copperdogma/death-fortune-teller/docs/hardware/BOJACK 10 Colors 200 pcs 5mm LED Diode Lights Assored Kit Pack (Transparent DC 2V - 3.2V 20mA) Bright Lighting Bulb Lamps Electronics Components 5 mm Light Emitting Diodes Parts/BOJACK 10 Colors 200 pcs 5mm LED Diode Lights Assored Kit Pack (Transparent DC 2V - 3.2V 20mA) Bright Lighting Bulb Lamps Electronics Components 5 mm Light Emitting Diodes Parts.jpg

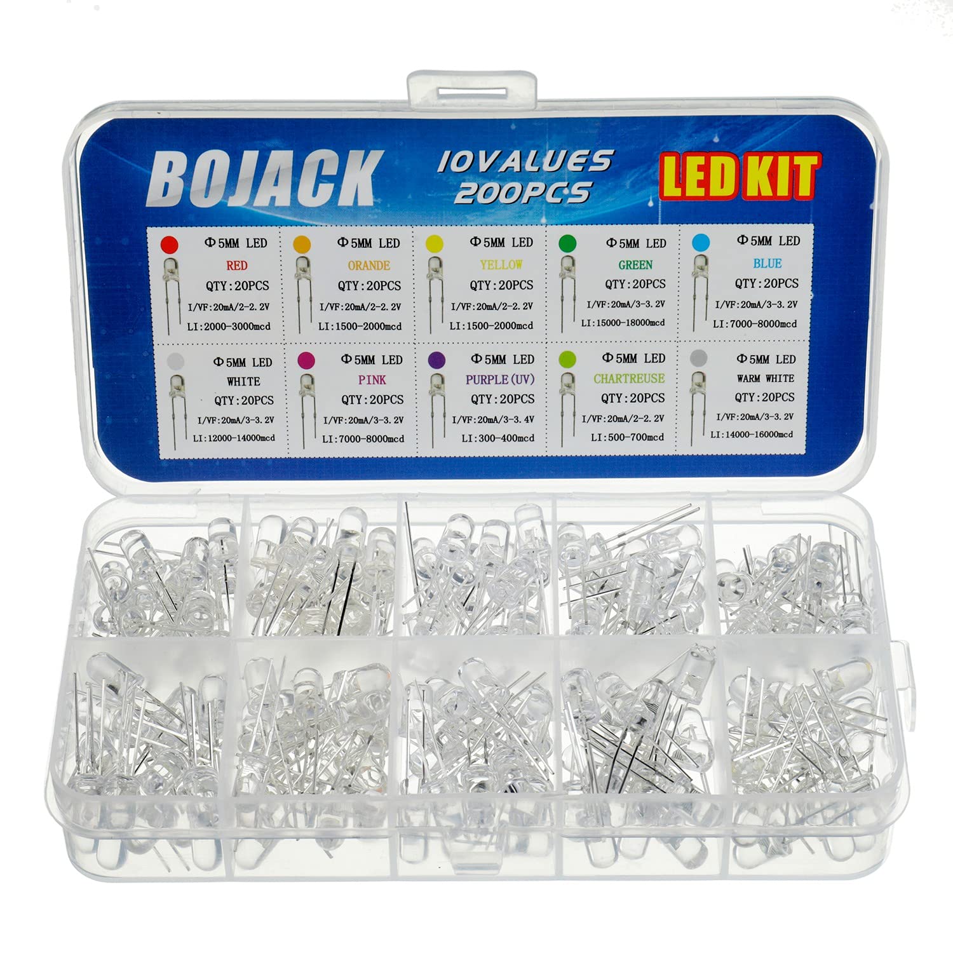
docs/hardware/BOJACK 10 Colors 200 pcs 5mm LED Diode Lights Assored Kit Pack (Transparent DC 2V - 3.2V 20mA) Bright Lighting Bulb Lamps Electronics Components 5 mm Light Emitting Diodes Parts/BOJACK 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
