copperdogma/death-fortune-teller/docs/hardware/Barrel jack, 2.1mm 13mm hole.jpeg

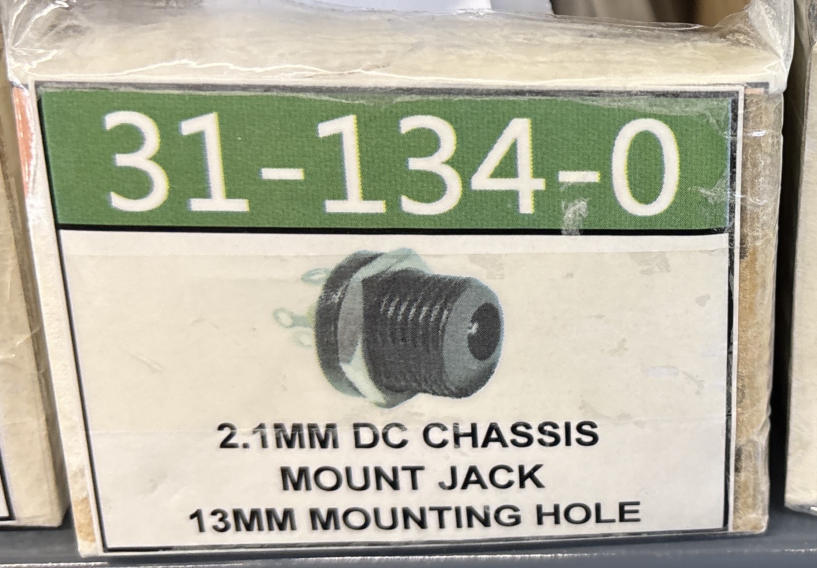
docs/hardware/Barrel jack, 2.1mm 13mm hole.jpeg
