copperdogma/death-fortune-teller/docs/hardware/BOJACK 10 Colors 200 pcs 5mm LED Diode Lights Assored Kit Pack (Transparent DC 2V - 3.2V 20mA) Bright Lighting Bulb Lamps Electronics Components 5 mm Light Emitting Diodes Parts/BOJACK 10 Colors 200 pcs 5mm LED Diode Lights specs.md

# BOJACK 5 mm LED Kit — 10 Colors (200 pcs)

* **Package:** 10 colors × 20 pcs each = **200 pcs**
* **Form factor:** 5 mm, clear lens (through-hole)
* **Nominal drive:** **20 mA**
* **Specs per color** (Vf = forward voltage @ 20 mA, LI = brightness in mcd):

| Color | Qty | Vf (V)  | LI (mcd) |
| --- | --: | --- | --- |
| Red |  20 | 2.0–2.2 | 2,000–3,000 |
| Orange |  20 | 2.0–2.2 | 1,500–2,000 |
| Yellow |  20 | 2.0–2.2 | 1,500–2,000 |
| Green |  20 | 3.0–3.2 | 15,000–18,000 |
| Blue |  20 | 3.0–3.2 | 7,000–8,000 |
| White |  20 | 3.0–3.2 | 12,000–14,000 |
| Pink |  20 | 3.0–3.2 | 7,000–8,000 |
| Purple (UV) |  20 | 3.0–3.4 | 300–400 |
| Chartreuse  |  20 | 2.0–2.2 | 500–700 |
| Warm White  |  20 | 3.0–3.2 | 14,000–16,000 |
