copperdogma/death-fortune-teller/docs/hardware/HS-125MG 24g Metal Gear Analog Slim Thin Wing Servo/HS-125MG Servo.md

# HS-125MG Servo - Hardware Reference

## Product Overview

**Model:** HS-125MG  
**Part Number:** 32125S  
**Type:** Analog Slim Thin Wing Servo  
**Weight:** 24g (0.84 oz)  
**Manufacturer:** Hitec RCD

## Description

The analog HS-125MG is a super thin servo measuring 1.2" x 0.4" x 1.3". Featuring Hitec's MP Gear technology, the HS-125MG is very durable and perfectly designed to fit in the slim wings of today's high performance gliders and aircraft.

## Key Features

- **Super Thin Wing Servo** - Compact form factor for slim wing applications
- **Strong Metal Gears** - Durable metal gear train
- **Dual Ball Bearings** - Smooth operation and reduced wear
- **Perfectly Designed** - Optimized for slim aircraft and glider wings

---

## Performance Specifications

| Parameter | Value |
|---|---|
| **Operating Voltage Range** | 4.8V ~ 6.0V DC |
| **Speed @ 60° (4.8V)** | 0.17 sec |
| **Speed @ 60° (6.0V)** | 0.13 sec |
| **Maximum Torque (4.8V)** | 42 oz-in / 3.0 kg-cm |
| **Maximum Torque (6.0V)** | 49 oz-in / 3.5 kg-cm |
| **Current Draw (Idle)** | 8 mA |
| **Current Draw (No Load)** | 230 mA |
| **Stall Current Draw** | 1,200 mA |
| **Dead Band Width** | 1 µs |

---

## Physical Specifications

| Parameter | Value |
|---|---|
| **Dimensions (Imperial)** | 1.18" × 0.39" × 1.33" (L × W × H) |
| **Dimensions (Metric)** | 30.0mm × 10.0mm × 34.0mm (L × W × H) |
| **Weight** | 24.0g / 0.84 oz |
| **Case Material** | Plastic |
| **Output Shaft Type** | Micro 25 |
| **Dust/Water Resistance** | N/A (Not rated) |

---

## Technical Specifications

| Parameter | Value |
|---|---|
| **Circuit Type** | HT7003 Analog SMT |
| **Motor Type** | 3 Pole Metal Brush Ferrite |
| **Gear Material** | Metal |
| **Bearing Type** | Dual Ball Bearing |
| **Connector Gauge** | 25 AWG / 40 Strand Count |

---

## Recommended Applications

### Suitable For:
- **Sport Planes:** 42-50 oz models
- **Sailplanes:** 3 meter class
- **3D Performance:** 42-50 oz models
- **Slim wing aircraft**
- **High performance gliders**

### Not Recommended For:
- Parkflyers
- Scale aircraft
- Electric helicopters
- Gas helicopters
- Ground vehicles (RC cars, trucks, buggies)
- Marine applications

---

## Power Requirements

### Voltage Performance Chart

| Voltage | Speed (sec/60°) | Torque (oz-in) | Torque (kg-cm) |
|---|---|---|---|
| 4.8V | 0.17 | 42 | 3.0 |
| 6.0V | 0.13 | 49 | 3.5 |

### Current Consumption

- **Idle:** 8 mA
- **Operating (No Load):** 230 mA  
- **Stall:** 1,200 mA (1.2A)

**Note:** Ensure your receiver and power system can handle the 1.2A stall current if multiple servos may stall simultaneously.

---

## Dimensions Diagram

```
Top View:
┌──────────────────────────────┐
│                              │  10.0mm (0.39")
└──────────────────────────────┘
        30.0mm (1.18")

Side View:
        ┌────────┐
        │  Servo │  34.0mm (1.33")
        └────────┘
```

---

## Mounting Information

- **Output Shaft:** Micro 25 spline
- **Mounting Tabs:** Standard servo mounting pattern with 4 mounting holes
- **Thickness:** 10.0mm - designed for thin wing sections

---

## Compatibility Notes

- Standard analog servo signal (PWM)
- Compatible with all standard RC receivers
- Micro 25 output shaft requires compatible servo horns/arms
- Thin profile specifically designed for wing servo applications

---

## Related Products

- **HS-5125MG** - Digital version with improved resolution
- **D145SW** - Steel gear digital alternative
- **D131MW** - Coreless metal gear digital option
- **Metal Gear Set** (Part #: replacement gears available)

---

## Additional Information

**Product URL:** https://hitecrcd.com/hs-125mg-slim-metal-gear-wing-servo/  
**Manufacturer:** Hitec RCD USA  
**Support:** SERVICE@HITECRCD.COM  
**Status:** Check current availability (was listed as "OUT OF STOCK" at time of reference)

---

## Document Information

**Document Type:** Hardware Reference Specification  
**Created For:** AI-readable hardware project documentation  
**Last Updated:** October 2025  
**Source:** Official Hitec RCD product documentation
