copperdogma/death-fortune-teller/docs/ESP32-WROVER-UART.md

# ESP32-WROVER-UART

Excellent questions — UART on the ESP32 is flexible but has some key constraints. Let’s go through this clearly and practically, focusing on your Freenove ESP32-WROVER board.

⸻

🧠 1. The ESP32 Has 3 Hardware UARTs
	•	UART0 — primarily used for programming and debugging (via USB-serial bridge).
	•	UART1 — available for user use, but often partially used by flash operations depending on your setup.
	•	UART2 — fully available for user use.

UART	Typical Use	Default TX/RX Pins	Notes
UART0	Serial console / upload	GPIO1 (TX0), GPIO3 (RX0)	Used by USB interface. You can use it for debugging, but avoid repurposing it if you still need serial upload.
UART1	Secondary UART	GPIO10 (TX1), GPIO9 (RX1)	These defaults are often not usable on dev boards because those pins are connected to flash memory. You can reassign.
UART2	Secondary UART	GPIO17 (TX2), GPIO16 (RX2)	Usually free and safest for general use.

⸻

⚙️ 2. You Can Remap UART Pins Freely

One of the best things about the ESP32 is that most peripheral signals are routed via an internal “IO matrix.”
That means you can map UART TX and RX signals to almost any GPIO — except a few restricted ones (see below).

Example in Arduino:

HardwareSerial MySerial(2);  // Use UART2

void setup() {
  MySerial.begin(9600, SERIAL_8N1, 4, 15); // RX=4, TX=15
  Serial.begin(115200);
}

void loop() {
  if (MySerial.available()) {
    Serial.write(MySerial.read());
  }
}

That gives you a second UART on GPIO4 (RX) and GPIO15 (TX), completely independent of the default serial port.

⸻

⚠️ 3. Pin Restrictions

Not all GPIOs are equal — here’s what to avoid:
	•	GPIO6–11 → used by the onboard flash (don’t touch).
	•	GPIO0, 2, 12, 15 → have special functions during boot; avoid unless you know what you’re doing.
	•	GPIO34–39 → input-only (can’t be TX).

Safe choices for UART RX/TX:
4, 5, 16, 17, 18, 19, 21, 22, 23, 25, 26, 27, 32, 33

⸻

🔢 4. Maximum Number of UART Devices
	•	There are 3 hardware UART controllers (UART0–2).
	•	So, you can have up to 3 separate UART connections simultaneously.
	•	One is typically used for the USB serial (programming/debug).
	•	That leaves two hardware UARTs free for your own devices.

If you need more, you can:
	•	Share one UART among multiple devices (using tri-state lines or bus control — not ideal), or
	•	Use SoftwareSerial (bit-banged) — but ESP32’s software UART is CPU-intensive and unreliable at high speeds. Use it only for slow sensors (under ~9600 baud).

⸻

⚡️ 5. Typical Setup on a WROVER Board

For most projects:
	•	UART0 → USB serial (no changes)
	•	UART2 → external UART device (e.g. GPS, serial sensor)
	•	Optionally UART1 → another serial device if needed, on remapped pins

Example:

Function	UART	TX Pin	RX Pin
Programming / Serial Monitor	0	1	3
GPS (external)	2	17	16
Debug / Sensor (optional)	1	23	19

⸻

🧩 Summary

Feature	Details
Hardware UARTs	3 total (UART0–2)
Freely remappable	Yes, any GPIO except restricted ones
Safe pins	4, 5, 16–19, 21–23, 25–27, 32–33
Max concurrent UARTs	3 (usually 2 free for you)
Software UART	Possible, but limited speed/reliability

⸻

If you tell me which external devices you plan to connect (e.g. a Bluetooth module, GPS, printer, etc.), I can recommend which UARTs and pins to use safely for your specific build.
