copperdogma/death-fortune-teller/ai-work/stories.md

# Project Stories

Death, the Fortune Telling Skeleton

**Note**: This document serves as an index for all story files in `/docs/stories/`, tracking their progress and status.

---

## Story List
| Story ID | Title | Priority | Status | Link |
|---|---|---|---|---|
| 001 | PlatformIO Firmware Bring-Up | High | Done | /docs/stories/story-001-platformio-firmware-bring-up.md |
| 002 | SD Audio Playback & Jaw Synchronization | High | To Do  | /docs/stories/story-002-sd-audio-playback-jaw-sync.md |
| 003 | Matter UART Trigger Handling | High | To Do  | /docs/stories/story-003-matter-uart-trigger-handling.md |
| 004 | Capacitive Finger Detection & Snap Flow | High | To Do  | /docs/stories/story-004-cap-sense-snap-flow.md |
| 005 | Thermal Printer Fortune Output | Medium | To Do  | /docs/stories/story-005-thermal-printer-fortune.md |
| 006 | Bluetooth A2DP Reliability & Testing | Medium | To Do  | /docs/stories/story-006-bluetooth-a2dp-reliability.md |

## Notes
- Story IDs map to future files in `/docs/stories/`; create each file as work begins.
- Update priorities and statuses as planning evolves and milestones complete.
- Consider splitting stories if scope expands beyond a single deliverable.
