copperdogma/death-fortune-teller/docs/stories/story-017-audio-integrity-servo-noise.md

# Story 017 — Audio Integrity and Servo Noise

Status: In Review — audio accepted; breathing retained, servo noise unresolved

## Goal

Resolve the remaining audible static and servo noise while preserving the accepted Matter flow and printer behavior from Story 016.

## Acceptance

- Welcome, fortune preamble and goodbye sound clean to Cam, with raw PCM integrity and underrun telemetry checked against the verified card backup.
- Identify whether servo noise is mechanical or speaker interference; apply and physically verify the appropriate correction without losing jaw animation.
- Start, Dead Stop and Waiting retain their accepted behavior.

## Work log

### 20261025-2211 — Checkpoint pushed; resumed audio and servo work

- **Action:** Committed accepted native rebuild and demo controls as `5ca00cb`, merged the independent remote project-context document, and pushed `main` at `01b7631`. Verified remote hash matches. Unrelated Cursor plan and untracked schematics remain untouched.
- **Evidence:** Story 015 established wrong raw PCM bytes from original card locations on this ESP32, including an isolated older SDK test. The fresh initialized clip returned the expected hash twice and Cam heard clean audio. This supports testing fresh allocation for all clips, without claiming the physical cause is established. Qualified TwoSkulls reader remains restored.
- **Next:** Requested approval for a preserved-original audio-folder rebuild and clarification of servo noise type. Read-only servo implementation/hardware audit delegated; root owns all hardware access. No firmware or card changes yet.
- **Observation:** Attempt to open live serial without reset failed during termios setup with EINVAL; no command was sent. Inspect ownership/device state before retrying.

### 20261025-2215 — Prepared controlled comparisons

- **Audio:** Reverified all 40 staged audio-folder files (22,010,672 bytes) against the preserved card backup: zero mismatches. Nine actual WAVs show only 0–0.0002% of samples near full scale; this does not establish clean source audio by listening, but provides no evidence of widespread hard clipping. AppleDouble metadata is excluded from WAV decoding. Card changes remain pending approval.
- **Servo audit:** Card calibration already uses historical quiet 1750..2100 µs reversed limits. Current 50 Hz hardware PWM uses a separate timer from eyes, avoids redundant writes, and has power management disabled. Historical issue notes describe movement buzz even when fixed positions were quiet; do not treat an old redundant-write hypothesis as a demonstrated fix.
- **Next:** Prepare idle-only normal/hold/off pulse diagnostic commands, defaulting to existing normal behavior, before any firmware test. Compare by listening after Cam identifies the noise type. Source/research details will accompany implementation; no calibration changes or hardware wiring changes planned.

### 20261025-2225 — Approved card rebuild; mechanical noise isolated by scope

- **Human input:** Cam identifies mechanical jaw buzzing/chatter and approves rebuilding all audio files while preserving the original folder. Requested card transfer to the computer; card not mounted yet. No card changes performed.
- **Resource recovery:** Disk now has about 4 GiB free; no agent cleanup was performed. General host sanitizer suites and Death flow/assets/fortune suites now pass, including new jaw-mode transition tests. Native diagnostic build is running.
- **Servo:** Added idle-only `jaw-mode normal|hold|off`, default normal after reboot. Hold suppresses motion at calibrated closed target; off stops pulses while preserving eyes; resume forces pulse restoration and a fresh idle cadence. No calibration change. Research and remaining uncertainty recorded in `docs/research/2026-10-25-servo-noise-isolation.md`.
- **Card operation preparation:** `scripts/rebuild_audio_folder.py` checks the exact 40-file staging against backup and current card, copies to a new directory, fsyncs, verifies twice through uncached reads, then archives the original folder and switches the new one into place. Existing extras (including the earlier diagnostic copy) remain in the archive. Local temporary-directory rehearsal passed dry-run/no-mutation, full verification, preserved extra file, and repeat/overwrite refusal. Ready for the approved physical-card operation; no formatting or existing-file deletion.
- **Build result:** Native ESP-IDF diagnostic build passed. Not flashed while awaiting the requested card transfer; accepted printer/flow firmware remains installed. New experimental work remains uncommitted.

### 20261025-2235 — Reader reproduces corruption; card writes stall before switch

- **Preflight:** Card mounted as H-DEATH, disk4s1, FAT16, UUID E25CA0ED-2D75-379D-BA54-C01AF20645BD. Strict guard stopped before writes because seven WAVs differed from backup. Two preserved uncached snapshots of each of nine WAVs showed seven mismatching/changing files. Original initialized returned three changing hashes; fresh diagnostic copy remained exact across three reads. Earlier computer-reader consistency no longer holds.
- **Preservation:** Saved snapshots/report under ignored `card-reader-unstable-before-rebuild`. Reviewed explicit unstable-original restore path: no original data writes, unchanged path/size/mtime checks, source remains exact verified backup. Local differing-original rehearsal passed.
- **Copy attempt:** Initial metadata copy stopped on exclusive-creation collision with macOS-generated AppleDouble; retained metadata-only staging under `audio-rebuild-attempt1-20261025`. Reworked new active content to nine WAVs only, leaving all metadata in original archive; local test passed. Primary Apple source and decision recorded in SD research note.
- **Stall:** Second attempt hung on `mkdir` (confirmed by process sample), and a separate directory listing also entered kernel I/O wait. No verification/switch completed; original `audio` folder not renamed or rewritten. Sent SIGINT to the owned copy process to prevent continuation after the blocked call returns. Requested normal disk4s1 unmount, pending. No forced unmount, format, cleanup or flash performed. Candidate servo image SHA256 f8b65a03448954f504a575978e48ca2ba8412a43309ad80e4d1e3e176060e4c5 remains unflashed.
- **Next:** Resolve removable-media I/O stall before further card writes. Replacement card is the practical next cross-test given corruption now reproduced outside ESP32; card versus reader hardware is not conclusively separated. Servo listening still requires powered board and human feedback.

### 20261025-2239 — Retry completed; nine fresh assets verified

- **Human steering:** Cam suspected Finder had crashed and requested another attempt. Confirmed old copy/unmount processes had exited and volume access responded. Retained the failed staging entry under `audio-rebuild-attempt2-20261025`; original audio still intact. Added per-file progress reporting before retry.
- **Result:** Retry copied all nine actual WAV assets (21,865,236 bytes), passed two uncached whole-folder verification passes and final post-switch verification. Original 42-file folder retained as `/audio-original-20261025` with paths/sizes/mtime preserved and no data writes; original readback hashes still differ across reads, explicitly reported `original_readback_stable=false`. Do not mistake successful retry for restored original read integrity or proof of Finder causality.
- **Evidence:** Ignored `audio-folder-rebuild-retry-result.json` reports verified=true/original_preserved=true/original_bytes_not_written=true. Active `/audio` contains exact qualified backup WAVs. Mac metadata remains in original archive; failed staging entries retained, no cleanup or format.
- **Next:** Normal unmount, return card to Death, verify streamed PCM and listening for Welcome/preamble/goodbye. Then flash built servo diagnostics and compare normal/hold/off mechanical sound. No firmware flash or new commit performed yet.

### 20261025-2242 — Fresh Welcome matches on ESP32

- **Return:** Cam returned card, powered board and reconnected USB. Non-reset serial attached successfully. SD mounted, nine active assets found, saved speaker connected, no stream fault.
- **Welcome:** Local `/audio/welcome/welcome2.wav` completed 540540 frames, raw FNV1a `f5800043` exactly matching verified backup, 1079500 nonzero samples/peak32761, zero underruns. This is device-side evidence of correct fresh-location data through a full 12.26-second clip. Human listening question pending.
- **Next:** Playing `/audio/fortune_preamble/fortune_2_typewriter.wav` as a longer data-integrity comparison. No printing triggered. Servo diagnostic image remains built/unflashed until current playback is finished.

### 20261025-2244 — Longer stream exact; servo image flashed, warm SD init blocked

- **Audio:** Cam answered Welcome sounded “Clean.” Fortune preamble 2 completed 746337 frames, raw FNV1a `db38260b` exactly matching backup, 1491196 nonzero samples/peak20593, zero underruns. Human preamble listening acceptance and goodbye remain pending. Validation report captures the separate machine/human results.
- **Flash:** Closed serial after explicit Stop/Waiting. App-only upload at 0x30000 verified hash for diagnostic candidate f8b65a03448954f504a575978e48ca2ba8412a43309ad80e4d1e3e176060e4c5; NVS/Home preserved. Controlled reset launched application.
- **Current boot:** SD card initialization times out in OCR/send_op_cond before actuator/config/radio startup. Repeated mount retries report ESP_ERR_TIMEOUT; no jaw comparison possible yet. Servo diagnostics run after mount, so no evidence that jaw-mode logic causes this initialization failure. Requested one full power removal including USB to reset card and board. No blind firmware rollback, card format, or new wiring changes.

### 20261025-2255 — Separated motion chatter and damaged recording samples

- **Power-cycle result:** SD initialized, speaker reconnected, startup announcement completed. Hold mode was accepted. Cam: held jaw “Quiet now”; normal breathing “noisy during movement, quiet between breaths.” Returning to hold quieted jaw for audio tests. Continuous idle holding torque was not noisy in this comparison; pulse-off comparison unnecessary at this point.
- **Goodbye:** Full 887196 frames delivered, backup FNV `6a740064`, zero underruns, repeated exact on replays. Cam corrected initial clean assessment to about six clicks, repeating exactly near halfway and in the final five seconds. Treat as remaining audible defect, not acceptance.
- **Source diagnosis:** Compared all nine project WAVs against the card backup: six backup WAVs contain sparse predominantly single-bit PCM changes. Goodbye has 616 differing bytes/635 bits and isolated full-scale impulses; project original has no matching impulses and peak19552. At10.940476s backup samples -21/-32766/23 correspond to project -21/2/23. Source spikes match reported click timing. Exact prior stream hash proves faithful damaged-backup playback, not pristine audio. Full evidence in `docs/research/2026-10-25-audio-source-bit-damage.md`.
- **Pristine preparation:** Independently read project originals uncached twice, snapshotted all nine (21,865,236 bytes), verified snapshot and saved manifest. Pristine Goodbye FNV `487245a5`. Rehearsed restore preserving both earlier folders; PASS. Cam transferred card for this restore. No runtime audio filter or buffer change.
- **Current card operation:** Clean restore started with unique `audio-pristine-staging-20261025` and intended archive `audio-backup-copy-20261025`; stopped progressing after first file while creating next directory. Process sample again shows `mkdir` wait. Sent SIGTERM to owned process and requested normal unmount, both pending kernel I/O completion. Original archive and active backup-derived folder have not been switched/replaced. Asked about another reader or replacement card; no forced ejection, repair, format or repeated write loop.
- **Servo candidate:** Eased fractional idle/boot motion interpolates between existing integer-angle calibrated PWM values. Travel/timing/endpoints/speech/overrides preserved. Dense20ms monotonic/fractional/endpoint tests plus full general host sanitizer suite PASS; native build PASS. Candidate SHA256 `81d607261dc25165a0397734f6db8a5204b2cf1d4abe758035c7a67ef428babd`, not flashed. Current installed diagnostic image remains f8b65a03…, default normal on power-cycle. Mechanical improvement still needs listening.

### 20261025-2301 — Replacement card formatted and verified with original recordings

- **Prior operation release:** Stalled restore process exited after SIGTERM; normal unmount first reported Backblaze `bzserv` dissenter, then succeeded after its handles cleared. Backblaze was inspected read-only; no backup settings changed or service killed. Ejection blocker does not establish Backblaze as the cause of sample damage or directory stalls.
- **User action/scope:** Cam inserted a different card and authorized preparation, then explicitly requested formatting and the same name as old card. Replacement initially labelled WYZE_STOCK, FAT32, UUID F09E442D-04EF-392F-A76E-5117196E878D; old H-DEATH card UUID E25CA0ED-2D75-379D-BA54-C01AF20645BD remains untouched by this formatting. Preliminary non-destructive copy verified three times, then user-requested format erased replacement card contents.
- **Format:** Rechecked replacement UUID/name/whole disk immediately before `diskutil eraseDisk FAT32 H-DEATH MBRFormat /dev/disk4`. Succeeded. New volume UUID87906DF2-96A7-3A60-B001-5647BD0A287E.
- **Load/verify:** Copied nine pristine project WAVs, saved1125-byte config, exact727-byte fortune JSON and pirate BMP from verified local sources. All12files passed three uncached read-back SHA256 checks after fsync. No stalls or mismatches. Report/manifest retained as ignored `replacement-card-formatted-preparation.json`. Old card and its retained folders/backups remain available; camera image on replacement was erased only under explicit format authorization.
- **Next:** Safe eject, return replacement to board with USB, app-only flash smooth servo candidate, then verify pristine Goodbye against FNV487245a5 and listen for both clicks and jaw-motion change. No new commit/push after the accepted checkpoint.

### 20261025-2324 — Clean audio accepted; control timing remains under investigation

- **Installed:** App-only smooth candidate81d60726… flashed and hash-verified. Replacement SD initialized on first post-flash boot, startup staging/PSRAM hash bothd6d8b5d5, saved speaker reconnected. No full power-cycle recovery needed this time.
- **Audio acceptance:** Pristine Goodbye completed887196frames, FNV487245a5, peak19552, zero underruns. Cam: “Clicks are gone.” This verifies original source data rather than merely faithful playback of damaged backup bytes.
- **Servo trial:** Cam judged eased breathing “About the same” for noise. He explicitly wants to retain breathing. He notes the expensive servo is louder than Jeff/Anthony and O-rings already insulate mounts; don't repeat generic mounting advice or infer a mechanical cause from one unsuccessful smoothing experiment. Quiet holding and noisy movement do not rule out control timing.
- **Next experiment:** Passive MCPWM hardware edge capture on GPIO23, two channels rising/falling, without altering LEDC output. Bounded8second acquisition, internalISRring/PSRAMhistory, hardware timestamp analysis, recorded commanded duty, output configuration verification and cleanup. Both channel latches share APB with LEDC; capture gaps and common-mode clock drift are explicit interpretation limits. Captures will compare hold and normal breathing. New pure analysis and actuator telemetry tests plus allgeneralhost/Death suites PASS; native build running. Diagnostic does not change motion endpoints/timing/calibration. No hardware timing result yet.

### 20261025-2334 — Passive output measurement complete; breathing restored

- **Build/flash:** Native observer build and allhostsanitizer/Deathflow/assets/fortune suites PASS. App-only SHA5b2d61fb7a498f5c80552c5415aff7e997e6ecd725c33fc777e2f2407db83f11 uploaded/hash-verified. Replacement SD mounted immediately; startup staged/PSRAM FNVd6d8b5d5; speaker connected on second remembered attempt. No pairing/NVS reset.
- **Held capture:** 400 complete periods exactly20ms; pulse width2094.125µs constant; no ring drops/gaps/invalidwidths. Output GPIO configuration preserved after cleanup.
- **Breathing capture:** 399 complete periods exactly20ms; width2041.0125..2094.125µs; maximum adjacent change3.0625µs consistent with maximum programmed change3.05176µs atcapturequantization. No ring drops/gaps/invalidwidths, one initial/unpaired edge. Output configuration preserved after cleanup. Structured results in `docs/validation/2026-10-25-servo-pwm-capture.json`.
- **Interpretation:** No unexpected waveform jitter/malformed pulse observed in these windows. This does not rule out commanded movement/update cadence, analogue waveform/supply atservo, or mechanical load. Do not dismiss Cam's control-code hypothesis as disproven; expensiveunit/O-rings do not locate cause. Historical high-speed versusnative low-speed difference researched but not changed without a waveform-fault result.
- **Handoff:** Normal breathing enabled, Waiting, SD/speaker connected, printer idle, no stream fault/reset. Audio clicks accepted gone on original project recording/newcard. Mechanical movement noise remains; Cam explicitly requested retaining breathing and initially accepted its movement noise, with control-code investigation left as an open finding. Easing had no demonstrated acoustic benefit; no claim it fixed noise. Story remains InReview rather than marking noise eliminated. Current internalfree~25.7KiB, observed transientmin2.1KiB later inrun; no allocation failure/reset observed. Further resource/fullflowsoak remains future qualification. Observer releases runtime capture allocations/interrupts; CLI dormant when unused. New work uncommitted, old unrelated Cursorplan/schematics untouched.

### 20261026-1108 — Investigating intermittent Home Start interruption

- **Report:** Two Home Start attempts began speech and stopped early; a subsequent attempt appeared to work. Servo research paused. No cause established from that report.
- **Evidence preservation:** No reboot/flash. Initial serial attachment failed with macOS termios EINVAL, also reproduced by stty. User reconnected USB while instructed to retain main power; non-resetting relay then connected successfully. Current uptime ~773 seconds, Start acceptance counter4, Waiting, SD/speaker/stream available, radio fault0/dropped0. Latest playback delivered490880frames with zero underruns, producer had prepared497448frames; these partial counters cannot identify the earlier abort cause. Printer completed0/cancelled1. No durable SD log or general RAM log history exists in installed firmware. Earlier messages emitted while disconnected cannot be reconstructed from these counters.
- **Capture:** Private ignored log `firmware/build/validation/death-first-flash-20261025/story017-intermittent-start-20261026.log`. Asked Cam to run one Home Start with logging attached, noting completion/early stop and Waiting behavior. No new Start captured yet at this checkpoint.
- **Diagnostic gap:** Existing show abort paths all log only State=cancelling. Added reason/phase/asset/uptime and a small fixed-size last-interruption snapshot, retained across later shows until init/reboot, exposed in regular status. Distinguishes explicit Dead Stop, speaker stream loss, audio prepare/read/start failure, prebuffer timeout and printer timeout. Added selected-asset/expected-frame logging and boot esp_reset_reason output. No SD writes, playback/provider/buffer changes, retries or recovery-policy changes.
- **Research/application:** General problem class is intermittent asynchronous failure with missing fault provenance. Existing installed ESP-IDF esp_system.h documents reset-reason distinctions (panic/watchdog/brownout/software); use that API rather than infer a reboot from silence. Volatile last-fault retention plus live serial capture is the bounded next experiment; it cannot recover past events or survive power loss. The pySerial API documents port-setting failures/possible line activation on open; no reset pulses were intentionally sent.
- **Validation:** Production-source Death flow/assets/fortune ASan/UBSan suites PASS, including retained failure across later playback, precise link-loss/timeout/read-failure reasons, and Stop/error race precedence. Native firmware build PASS; git diff --check PASS. Diagnostic candidate compiled only; not flashed while preserving current run. No commit/push.

### 20261026-1112 — Reproduced cutoff: explicit SD CRC failure

- Cam reports Welcome stopped at “…Death, the diviner, oracle of—”. Live capture shows Home Start accepted uptime978890ms, Welcome978910ms, SDMMC error986180ms: sdmmc_read_sectors_dma sdmmc_send_cmd returned0x109, status0x900; diskio_sdmmc read failed. Cancelling986220ms, cooldown986240ms, Waiting998250ms. No intervening Dead Stop command, Bluetooth state loss, reboot or underrun. Failure is an SD read/CRC failure, not evidence of Home rejecting Start or queue starvation. This is the replacement card, not the previously replaced card.
- Last successful producer block363/320166frames; delivered314752frames (~7.14s). Radio remained connected/stream-ready/fault0. Mounted flag1 describes filesystem state, not ongoing read integrity; previous status headline cannot establish card health.
- Next normal-jaw local Welcome replay failed at initial read within20ms, same0x109/status0x900. No fortune queued. Existing files unchanged. Next bounded comparison disables jaw PWM only temporarily, retaining all saved settings and restoring normal breathing after capture. CRC failure could reflect card/socket/power/signal/controller path; current evidence does not identify which.
- Primary references checked: ESP-IDF5.5.4 esp_err.h defines0x109 ESP_ERR_INVALID_CRC; sdmmc_cmd.c read path propagates failed transfer and checks CMD13. Espressif v5.5.4 SD example documents signal integrity/pullup/clock requirements: https://github.com/espressif/esp-idf/blob/v5.5.4/examples/storage/sd_card/sdmmc/README.md . Earlier low-clock failures concerned the old card and silent wrong bytes; do not assume their result proves this replacement-card CRC failure has the same cause.

- **Jaw isolation results:** Normal local replay1056040ms failed CRC at1056060ms during initial read. PWM-off replay1091700ms completed540540frames/rawFNV9f4f6cb1/peak19558/zero underruns. Restored-normal replay1133890ms failed CRC1137690ms after162304deliveredframes. Second PWM-off replay1172640ms failed CRC1172660ms before first PCM block. Thus motion/pulses are not required to reproduce the error; no servo-causal conclusion from one passing off trial. GPIO pulse-off does not physically isolate servo power.
- **Restored:** Jaw mode normal accepted1216280ms; Waiting, SD still mounted, speaker connected, zero radio fault/drops. Saved settings/files unchanged. No reset/flash performed. Diagnostic-only source candidate remains built/tested but uninstalled. Cutoff mechanism established; underlying CRC cause and durable fix remain open. Next useful controlled test is replacement-card SD clock reduction with hash-verified full clips, or measured card supply/socket/signal integrity. Do not add unchecked fread retries that could publish partial/corrupt blocks.
