copperdogma/death-fortune-teller/docs/stories/story-019-reliable-sd-playback.md

# Story 019 — Reliable SD playback on replacement card

Status: In Progress. User says intermittent stops are a killer and must be fixed.

## Acceptance

Establish a reliable operating configuration with hash-verified full clips,
repeated full-flow/Home Start use and idle/reboot recovery. Human playback/print
acceptance remains distinct from host/native build checks. Retain breathing,
Matter pairing and fault reports. No card formatting or asset modifications.

## Work log

### 20261026 — Baseline and bounded next experiment

- Logger-only checkpoint83497e7 pushed and remote verified. Exact staged tree host/Death flow/assets/fortune suites PASS; earlier servo experiments remain uncommitted. Unrelated Cursor plan/schematics preserved.
- Replacement-card baseline20MHz already has several CRC0x109 aborts, including full Home Start failures with speaker stream up/zero underruns and one failure with jaw pulses off. Successful Welcome has540540frames/FNV9f4f6cb1. New logger retained actual first failure while archive initially EIO, then recovered on a later SD write.
- General problem class: intermittent storage transport integrity, not PCM queue starvation. Bounded primary research confirms ESP-IDF5.5.4 supports reduced SDMMC clock, real-frequency query and external pullup requirements. Native source mounts1-bit at20000kHz; actual board pullup resistance/supply waveform not yet physically verified. Old-card low-clock/wrong-byte tests do not qualify replacement-card behavior.
- Added idle-only volatile `sd-clock 4000|10000|20000` with SDK real-frequency query. No CRC disable, audio buffer/reader/retry change, card remount or asset write. Boot baseline remains20MHz for now. Compare20 and10MHz on the same card/boot with normal jaw, exact clip hashes and full frame counts. Next steps follow the observed comparison rather than arbitrary retries.
- Sources: https://docs.espressif.com/projects/esp-idf/en/v5.5.4/esp32/api-reference/peripherals/sdmmc_host.html ; https://docs.espressif.com/projects/esp-idf/en/stable/esp32/api-reference/peripherals/sd_pullup_requirements.html ; https://github.com/Freenove/Freenove_ESP32_WROVER_Board . Manufacturer board reference does not prove this particular assembled board's electrical condition.

- Existing installed firmware already contained an older idle `sd-clock` branch, discovered during review; used it for live comparison without flash. Candidate consolidates the duplicate branch into the stricter guarded API with SDK real-frequency query. Fixed host aggregate fixture/linkage while qualifying the new API; targeted storage sanitizer test PASS. Initial new native build permission review timed out before execution (not a safety finding); no hardware change resulted and a single retry is available when needed.
- Same boot/card, normal jaw:20MHz Welcome aborted CRC0x109 after142592deliveredframes (~3.23s). Switched10MHz ESP_OK; next Welcome failed CRC during initial read. Switched4MHz ESP_OK; Welcome completed540540frames/FNV9f4f6cb1/zero underruns. Archive failures at20MHz also observed. One4MHz pass is a lead, not accepted fix; repeat and return to20MHz next.

- Repeated4MHz Welcome: full540540frames/FNV9f4f6cb1/zero underruns again. Returning20MHz on same boot immediately reproducedCRC at~2.0s/88704deliveredframes. Same normal jaw/speaker/reader/buffers throughout. This A/B/A materially links observed reliability to SD clock margin, while physical cause remains unmeasured. Restored4MHz and moved to longer fortune4 clip next. Manufacturer pinout labelsGPIO2/DAT0 shared with onboard LED; no populated schematic/external pullup evidence in repo. Treat loading/pullup/supply as hypotheses, not proven defective part.

- Longer fortune4 failed on its initial read even at4MHz. Therefore slower clock is not a verified fix; do not change boot default/adopt based on the two short passes. A4MHz direct initialized reference check still passed twice425700bytes/FNVd6d8b5d5 with zero bad chunks. Broadened framing from simple speed threshold to intermittent transfer integrity, potentially pattern/file/access-path dependent.
- Built diagnostic appaa10e63aa9d2d7e1c79f5f370ab2b59be7a9ac7d6127e33fd9df2c8db20ef184; app-only flashed/hashverified. Local SDMMC driver debug records enable only sdmmc_req at runtime, so response CRC versus data CRC raw interrupt status can be distinguished without SDK source edits. Added reversible idle `sd-continuous 0|1` via documented sdmmc_host_set_cclk_always_on; frequency change/reboot resets it. Continuous clock is an isolation experiment supported by the SDK, not a claimed migration regression (both old/new SDK gate clock by default).
- Asked Cam whether a multimeter is available; no measurement result yet. No wiring changes, card writes beyond existing fault logger or CRC suppression. Targeted storage sanitizer test and native diagnostic build PASS.

- Error-status image booted cleanly; initialized probe twice20MHz425700bytes/FNVd6d8b5d5 while speaker unavailable. No runtime CRC captured yet in that image. Bootstrap command-response timeout debug records are expected during card probing and are not classified as a new playback fault.
- Speaker reconnect attempts now fail/exhaust rather than delivering startup. Asked Cam whether JBL remains powered on; can continue read-only SD testing independently. Added `sd-file <catalogued audio path>` guarded against active show/audio/file/startup-playing/printer/tone. Generalized existing aligned4096 internal-DMA probe to8MiB cap without changing startup loading/provider or initialized reference checks. New API arbitrary-path/large-file bounds and every startup mode pass targeted ASan/UBSan; native build passes. This direct audit is a different read path from streamed PSRAM stdio, so interpret passing hashes narrowly. No source changes to waveform assets.

- General file-audit image6a6eb87ce2db8d9bc3f55f82b0c0c6750f09abf1135f13afa9345a5fe0fa394e installed/hashverified; full host suite PASS. Speaker currently disconnected/awaiting owner reply. At20MHz, aligned internal-DMA direct probes passed fortune4(3797364bytes,b828da54), Welcome(2162160,9f4f6cb1), Goodbye(3548784,487245a5). These are full pristine hashes of files that fail in playback, not acceptance of the streamed path. Auditing all9next and preparing an exact PSRAM stdio/cadence probe to discriminate I/O path from BT/speech-load effects before assigning electrical cause.

- Full aligned-DMA audit of all9clips at20MHz passed exact pristine FNVs;12total full-file reads including earlierthree, allcorrect. Corresponding read-only PCM totals match source data.
- Added controlled PSRAM-stdio audit:8192B PSRAM setvbuf,3528B PSRAM PCM buffer/882frame reads, one tick yield aftereach2blocks, same waveform parser/hash with no retries/gain/provider. This reproduces stream I/O shape but omits gain/muting/RMS/queue/network delivery. Both allocation-failure cases, 8MiB bounds and existing startup modes pass sanitizer tests. Native build required explicit FreeRTOS.h before task.h; fixed both production include order and host stub guard to catch regressions. Full host suite/native build PASS.
- Installed diagnostic imagede1a3b323cccd1f754676862422cc253a24817ae6a58d6c3204b9826c1b475b0 app-only/hashverified. At20MHz with no speaker stream, stdio audit passed fortune4(3797364,b828da54), Welcome(2162160,9f4f6cb1), Goodbye(3548784,487245a5). No runtime CRC status captured in these quiet-stream audits. WiFi/Matter and BT controller remain enabled; do not call this a radios-off test or conclude a specific radio/power cause.
- Speaker still unavailable after bounded retries/inquiry. Owner questions pending for JBL power and meter availability; need active speaker playback to reproduce/classify error under originalconditions and qualify any fix. No lowerclock default, automatic read retries or waveformchanges adopted. Remaining hypotheses include RF/power/load interaction, command/data protocol path and per-file/traffic timing; none proven. Continuous-clock diagnostic present but not yet tested under failing playback conditions. Normal breathing enabled, Waiting/startup awaiting speaker, bootdefault20MHz. Logging checkpoint83497e7 is pushed; new SD diagnostics remain uncommitted.

### Powered speaker and settling-controlled playback

- Cam confirmed speaker had powered off and turned it back on; meter available but not yet out. Mac serial reattach initially EINVAL; user USB reconnect fixed it without board reset. Later improved private serial relay to open at9600 then set115200 (standard pySerial supported sequence) and capture3600seconds; reopened successfully without another USB reconnect. This is host diagnostic plumbing, not an SD firmware fix.
- Cached JBL reconnected on first explicit retry, stream enabled/startup announcement delivered. With active silent BT stream, both PSRAM-stdio and aligned-DMA audits of fortune4 passed3797364bytes/FNVb828da54. Thus radio streaming alone did not reproduce the fault in these trials.
- Corrected isolation rigor: jaw off was allowed to settle ~12s before local fortune4 playback. Completed949341frames/FNVb828da54/zero underruns. Restored normal, settled, same full clip also passed exact hash/frames. Welcome at SDK-measured20000kHz then passed540540frames/FNV9f4f6cb1/zero underruns. Earlier rapid mode-switch/header-failure tests did not prove physical off had settled before I/O; do not overstate them as elimination of servo load.
- Human Home Start: Cam says whole thing played perfectly. Board logged full Welcome/preamble/one completed print/Goodbye487245a5/cooldown/Waiting, no read errors or interruptions. This is one accepted full flow, not a causal fix: only diagnostic features have changed and boot speed is still20MHz.
- Bounded Matter audit: OnOff attributes are NONVOLATILE; current app does not enable deferred persistence, so no configured3second deferred timer is active. SDK set_val may write NVS synchronously when values change. SDMMC ISR allocation flags0 mean flash cache/IRQ interaction is mechanically possible but no failing transfer was correlated with a flash write. Do not change persistence on this unproven hypothesis. Primary SDK flash-concurrency documentation: https://docs.espressif.com/projects/esp-idf/en/v5.5.4/esp32/api-reference/peripherals/spi_flash/spi_flash_concurrency.html .
- Meter readings pending; paused meter setup while repeated flows currently work. Next repeated full cycles, idle and reboot qualification. Root cause remains unresolved; no verified fix claimed.

- Warm/idle fault reproduced on the next serial full Start attempt: Welcome2780632ms, data error2780902ms, interruptstatus0x00008080; process_data_status reportsESP_ERR_INVALID_CRC (DATACRC plus end-bit error), not process_command_response. Cancel/cooldown followed. Logger SD export initiallyfailedtwicewithdataCRC0x80, subsequentlysavedslot5. This rules out calling the successful Home run a verifiedfix.
- Continuous20MHz clock test enabledESP_OK2862822ms, localWelcome2862832ms then dataCRC0x80 at2864512ms/68352deliveredframes (~1.55s). No underruns. Continuousclock is not a fix; restorednormalgating. Both lowerfrequency andclockgating hypotheses failed bounded testing. More clock sweeps are not justified.
- Requested meter3V3-to-GND idle reading now thatfaultreturned; measurements not yet received. Rechecking directstdio/DMA Welcome duringactivefailurewindow, then pausing new playback for rail checks. Keep normal breathing and current20MHzbaseline; no unverified fix adoption.

- During the warm failure window after restoring default clock gating, both read-only Welcome probes failed: PSRAM stdio2996722ms dataCRC0x80 (zero successful PCMbytes) and aligned-DMA2996772/2996802ms dataCRC0x80. Therefore the fault is no longer exclusive to playing or the PSRAM/bounce path; do not use the earlier good audits to claim that path proven reliable. Normal breathing/static probe jaw state and silent active BT continue. No further playback queued while awaiting meter idle3V3 reading. Both continuousclock and loweredclock have failed; electrical/card-interface isolation takes precedence over more speculative firmware tweaks.

### Meter measurements and next protocol comparison

- Cam measured board3V3-to-GND3.291V, unchanged through normal breathing, local Welcome and user-triggered full Home flow; bothaudio runs completed. Board5V/VIN idle4.68V, breathing unchanged, audio/load4.65V steady, reported audio completed. These display readings show no large sustained rail sag; they do not capture short transients and do not establish the rail as the fault cause. Do not raise supply/bypass protection based solely on these readings.
- Same native image after long idle (~32Msuptime): local Welcome540540frames/9f4f6cb1, Home full flow including regular fortune3(102fc78c), one additional completedprint and Goodbye487245a5; no new fault. Next serial Start for5V measurement queued withnormalmotion. Loggingandnormal20MHzbaseline remain intact. Intermittency remains unresolved despite successfulmeter-observedflows.
- Preparing compile-time SDSPI comparison on the SAME built-in socket: CLK14/MOSI15/MISO2/CS13, initial8MHz, mandatory SDK dataCRC checking, noformat/noassetwrites. This exercises anotherhost/protocol to distinguishSDMMCcontroller/interaction from sourcebytes/sharedcardwiring. Root will review and validate before app-onlyflash. FullpowercycleincludingUSB required afterflash so cardentersSPIfromcoldpower; shouldnotattemptprotocolswitchhot.
- Preserved currentnative rollback image privately as native-before-spi-de1a3b32.bin; exactSHAde1a3b323cccd1f754676862422cc253a24817ae6a58d6c3204b9826c1b475b0verified. NVS/fabrics not partofapp-onlywrites. NewmodeisdiagnosticuntilfullfileCRC/hash, sustainedaudio/fullflow/reconnect/resource checks pass.

### Owner correction: printer has been unpowered

- Cam clarifies printer power cable has been unplugged throughout roughly the last24hours to avoid repeated paper use and extra load. Current completed printer jobs mean UART transport completion only, not physical print or powered-printer load. Earlier wording about printer finishing/complete power-load tests overstated this; corrected interpretation here. Historical explicit human paper acceptance remains valid for those earlier powered tests, but do not transfer it to current SD qualification.
- Current3V3=3.291stable andVIN4.68idle/4.65audio measurements exclude powered thermal-printer load. SDCRCoccurswithoutprinterpowerdraw, so printerloadisnotnecessaryforthefailure. Leave printerunpoweredthroughtransportcomparison; no paperrequired.
- First SPI-enabled link exceeded IRAM by7796bytes. Primary ESP-IDF5.5.4 RAM guidance documents disablingSPI_MASTER_ISR_IN_IRAM as a supported IRAM saving, with flash-operation/performance tradeoff. Preparing a separate ignored SPI-test sdkconfig with that ISR optimization disabled; original native sdkconfig/rollback retained. This matches the nativeSDMMC interrupt's existing non-IRAM service property rather than changing audio settings or silicon target. MustmeasureSPIthroughput/resourcesbeforeadoption. SPIbus/mount/unmount/pins/noformat/disabled-native-diagnostics hosttests PASS under sanitizers.

- SPI ISR-in-flash profile recovered6040IRAMbytes but still exceededIRAMby1756. Did not stack arbitrary optimizations: map analysis showed moving task-only ringbuffer functions would save only1240bytes, insufficient. Selected SDK-documented revision3 target for this confirmedESP32-D0WD-V3 rev3.1 instead; it drops obsolete rev1/2PSRAMcachecompiler/ROMworkarounds, documented to save10KiB+. Rebuilt testprofile from originalsdkconfig with onlyrevisionchoice changed, restoring SPI ISR-in-IRAM baseline. This is a hardware-specific diagnostic profile, not a claim that revisiontargeting itself fixesSDCRC. If SPI is stable, native-vs-SPI interpretation must account for the profile difference; matching revisiontarget nativecontrol remains a possible follow-up.

- Revision3 SPI build succeeded with8485bytes staticIRAMfree and23824bytes staticDRAMremaining (before runtimeallocations). Restored SPIISR-in-IRAMbaseline in the rev3profile; earlier ISR-in-flashprofile is not the activecandidate. Added sdspi_host/spi_master logcapturetags and a host filtertest so realSPI errors are retained. Allgeneralhostsuites, includingnewSPIbus lifecycle/wiring/failurecases, PASS.
- SPIcandidateSHA58d88e5ea47433fd17e6cffe3d94736919fc2bdf2621e7043cb6c27f87d7f4d6 app-onlyflashed/hashverified. BoardleftinROMbootloader(no_reset). Requested fullpowerremovalUSB+main10seconds, cardinplace,printerunpowered,JBLon. Awaitingconfirmedcoldpowercycle; no SPI mount or reliability claim yet. Testconfigurationpathfirmware/build/sdkconfig.spi-test withESP32minimumrev3; DEATH_SD_SPI_TRANSPORT=ON in buildcache. Originalfirmware/sdkconfig andnative rollbackde1a3b32 preserved. After SPI mode, returningcardtoSDmodealso needsfullpowercycle.

### SPI timeout and native restoration

- Cam performed full10secondpowerremovalUSB+main/cardleftinplace. SPIcandidate booted but SD card initialization repeatedlytimedoutESP_ERR_TIMEOUT0x107; nofilesystemmounted and noaudio/assetwrite. Not accepted. Manufacturer pinout documents only3 1-bitSD signals; actual socketDAT3/CS-toGPIO13routewasnotverified beforetest. This wiringassumption should have been confirmedfirst. Timeout is inconclusive aboutSPIcontroller/cardintegrity; don'tretryclock/protocol guesses without verifyingCSwiring.
- App-onlyrestored exactnative de1a3b32 image/hashverified. Normalreset mountednativeSDMMCimmediately and startupPCM d6d8b5d5 verified; nosecondmanualpowercycle needed. NVSloggerrecoveredcompactSPIinitfault asintended. NativeHome/radio reconnect proceeding; allSDcontentunchanged.
- Next measurement whilemounted/SDidle: headerGPIO2/DAT0 andGPIO15/CMD toGND. NativeGPIO2hasinternalpulluponly(~45ktypical) andmanufacturerpinoutlabels onboardIO2LED; external10kpullup presence/resistorloadunverified. Primary ESP32datasheet VIH≥0.75VDD =>~2.468V atmeasured3.291V. SDKpullupguidanceexpects10kexternalCMD/DATpullups. LowDCidleGPIO2wouldsupportstaticbias concern; healthyDCdoesnotexcludeedge/transientnoise orproveLEDcausality. Noresistor/rewiringchange untilmeasurement. Primaryrefs: https://documentation.espressif.com/esp32_datasheet_en.pdf ; https://docs.espressif.com/projects/esp-idf/en/stable/esp32/api-reference/peripherals/sd_pullup_requirements.html .

### Corrected idle readings and independent driver review

- Owner confirms 3V3 **3.291 V** (3.91 was a typo), GPIO2/DAT0 **3.285 V**, GPIO15/CMD **3.285 V**. These supersede contradictory initial readings. No observed steady overvoltage or low bus bias. No added pull-ups or supply changes justified by these measurements; fast transients and actual resistor network remain unmeasured.
- Fresh read-only review of pinned ESP-IDF 5.5.4 found that existing `process_data_status` records receive **masked MINTSTS**, not full raw RINTSTS. Default interrupts exclude FIFO over/underrun (FRUN bit11); lack of FRUN in current logs does not exclude that fault. Existing four preloaded DMA descriptors cover the failing 4 KiB and 512-byte reads, weakening a simple mid-transfer descriptor-refill starvation explanation. Recovery already resets FIFO/stops DMA; CMD13 0x900 means READY_FOR_DATA+TRAN, not evidence of a card stranded mid-transfer.
- Next bounded experiment: optional first-error full-register capture before ISR clears/reset, with transaction-start baseline for sticky bits. Fixed RAM snapshot; task-context output only; no change to interrupt masks, transfer sizes, recovery, clock or audio buffering. Keep installed SDK unchanged via pinned generated diagnostic sources. One good and one failing short probe are the desired comparison, not an unbounded clock/retry sweep.
- Sources and rationale: [pinned HAL interrupt mask/status](https://github.com/espressif/esp-idf/blob/v5.5.4/components/hal/esp32/include/hal/sdmmc_ll.h), [driver descriptor/ISR implementation](https://github.com/espressif/esp-idf/blob/v5.5.4/components/esp_driver_sdmmc/src/sdmmc_host.c), [transaction recovery](https://github.com/espressif/esp-idf/blob/v5.5.4/components/esp_driver_sdmmc/src/sdmmc_transaction.c), [pull-up guidance](https://docs.espressif.com/projects/esp-idf/en/v5.5.4/esp32/api-reference/peripherals/sd_pullup_requirements.html). Espressif explicitly says an LED on GPIO2 ordinarily does not affect operation; LED presence alone is not a root cause. External pull-network/edge integrity remain unverified.

- Unchanged restored native image: read-only Welcome DMA probe at uptime866612ms PASS, 2162160 PCM bytes/FNV9f4f6cb1. Speaker reconnect still timed out three attempts despite owner reporting it on; no speaker playback qualification from this probe. This single pass does not resolve the warm intermittent failure.

- Owner explicitly reconfirms built-in socket only; verified active native compile database has zero top-level historical src entries. Old external SD.h code exists only in archived/history examples. All current tests, including the unsuccessful SPI experiment, target the onboard socket. Added explicit README boundary to avoid confusion.
- Fresh close comparison to qualified TwoSkulls57ff native source confirms matching native mount/pullups, 8x882 PSRAM ring,8192PSRAMstdio, fread framing, burst/yield and worker settings. Relevant SDK settings match; Death has extra diagnostics/Matter/printer/show work. See research note for live release-artifact provenance and limits.
- Optional register-capture build PASS; four generator/hash-refusal tests PASS. App-only diagnostic flashed/hash-verified SHA256 cdb34ad60b57d334021bce410009ba4288a22091e4b75a626b98dbc2da728672; native20MHz, SPI OFF, original sdkconfig retained, no fabric/card erase. First successful boot CMD17/512B captured raw/mask/dma all0, card/bus counters512; native mount and startup PCM d6d8b5d5 passed. This adds observability, no fix claimed. Private serial log story019-register-capture-run.log.

- Diagnostic-image read-only Welcome DMA and fortune4 stdio audits matched9f4f6cb1/b828da54. After JBL pairing button/reconnect, owner heard startup. Local Welcome delivered540540frames/9f4f6cb1/0underruns; full serial Start completed Welcome,fortune4(949341frames/b828da54),UART-only unpowered printer job,Goodbye(887196frames/487245a5),cooldown,Waiting. Worker minimum2156bytes;no new data fault. Requested human Home-trigger reproduction; capture remains armed. These passing runs do not establish a fix.

- Human Home Start run: owner reports Completed and "all sounding perfect so far." Board read fortune2 full746337frames/db38260b and Goodbye887196frames/487245a5,zero underruns,no new data fault,normal jaw,then cooldown. Retained SPI-init report successfully archivedslot7 once startup finished; no pending report. Keep Story019 InProgress: no root-cause fix implemented/verified, only capture instrumentation and bounded passing tests. Printer remained unpowered.

### Owner-requested checkpoint

- Cam accepted the current behavior as good for now and explicitly requested check-in/push. Checkpoint includes preceding audio/servo isolation work and current SD observability, not a claim of a repaired intermittent interface. Story019 remains InProgress.
- Final checkpoint validation: all native host suites PASS (including SPI lifecycle, startup probes, actuator/PWM and retained fault logs), Death Start/Waiting/Dead Stop/fortune/card-parser suites PASS, four pinned-register generator tests PASS, git diff whitespace checks PASS. Native diagnostic build and app-only flash were already verified above; no extra flash for this source checkpoint. Unrelated OTA-plan edits and schematics remain outside the commit.
