copperdogma/death-fortune-teller/docs/hardware/Adapter - barrel jack, 5VDC at 5amps, 2.1mm center pos, corded.jpeg

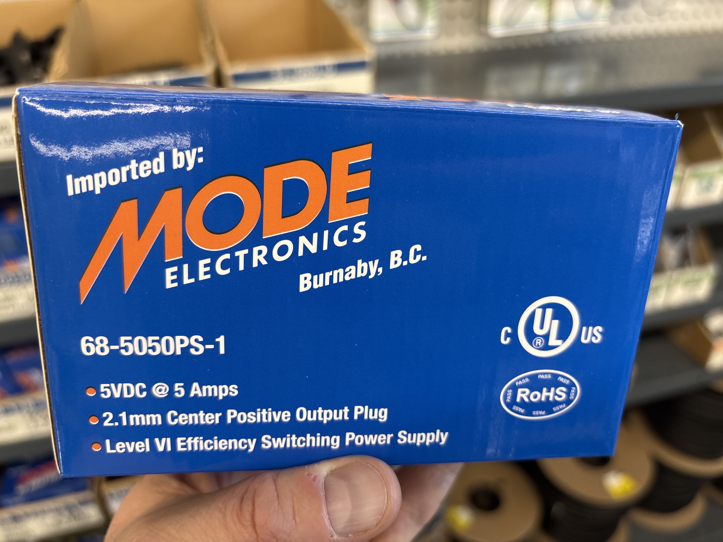
docs/hardware/Adapter - barrel jack, 5VDC at 5amps, 2.1mm center pos, corded.jpeg
