copperdogma/death-fortune-teller/docs/hardware/Freenove ESP32 WROVER/ESP32_Pinout_V3.0_hirez.png

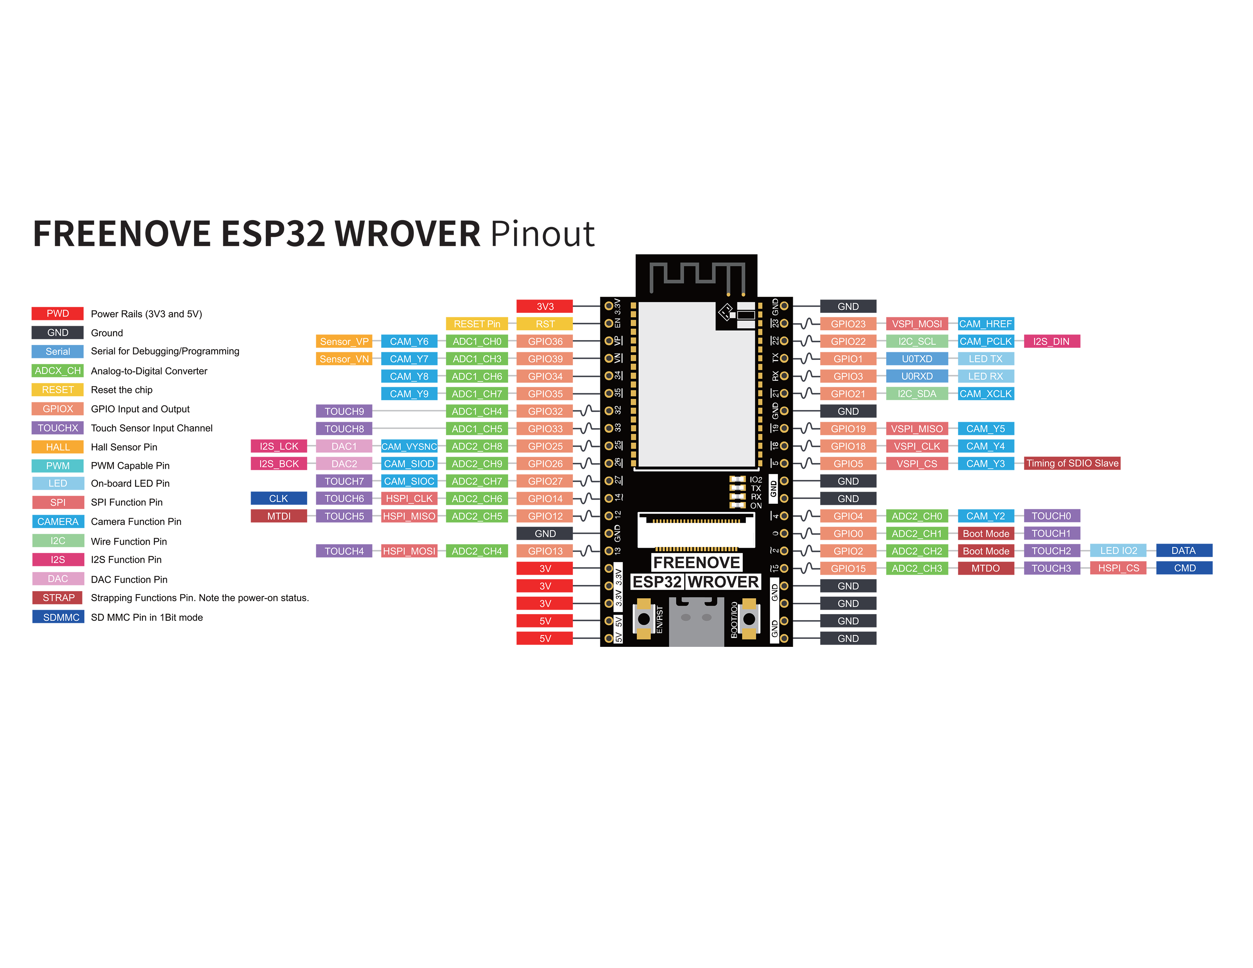
docs/hardware/Freenove ESP32 WROVER/ESP32_Pinout_V3.0_hirez.png
