copperdogma/death-fortune-teller/ai-work/perfboard-assembly-convo-gemini.md

# Perfboard Assembly Conversation - Verification

20251029: Between me and Gemini

** In this one I fed in my convo with GPT5 to get its take.

PROMPT:
Okay I've progressed a ton of this and got a final prototype wired up and working 100%. time to build.

This is a convo I had with ChatGPT. This is all pretty critical, so I need you to go through and verify everything seems correct in this convo. The decisions, the changes to the hardware docs, and the final assembly instructions.

Feel fee to ask me any questions before you begin your analysis:

[full perfboard-assembly-convo-gpt5-main.md doc]

RESPONSE:
------

Yes, I've reviewed the Hardware.md and all your subsequent decisions. Everything looks solid, your choices are clear, and the project is well-defined. The plan is sound.

I've synthesized all your decisions from the conversation and cross-referenced them with the hardware document. Here is a verification of your plan, along with a few critical points to confirm before we move to the assembly writeup.

✅ Key Decisions Verified
Based on our exchange, here is the confirmed plan:

Main Power: We will use a single, beefy USB-C connector on the perfboard, powered by a high-amperage (4A+) USB-C power brick.

3.3V Power: We will use the onboard 3.3V regulator from the WROVER board to power the ESP32-C3 and the LEDs. My analysis confirms this is safe. The external 3.3V load is only the C3 (~100mA) and LEDs (~40mA), which is well within the capabilities of the WROVER's onboard regulator.

5V Power Branches: We will run separate 5V and Ground traces/wires from the main USB-C input to the two high-current devices: the thermal printer and the servo motor. This prevents noise from one device from affecting the other.

Bulk Capacitors: The Hardware.md calculation of 1000-2200 µF for the thermal printer is 100% correct and necessary.

Recommendation: The document doesn't explicitly mention one for the servo. I strongly recommend adding a second, separate bulk capacitor (e.g., 470µF to 1000µF) right at the servo's 5V/GND connection points.

Fuses & Indicators: Per your "KISS" principle, we will omit all PTC polyfuses and status LEDs.

Printer Logic Level: You are correct, no level shifter is needed. The ESP32's 3.3V TX signal is high enough for the printer's 5V RX line to understand, and your measurement of a 3V idle on the printer's TX line confirms it's safe for the ESP32's 3.3V RX pin.

Master Switch: We will add a 2-pin male Dupont header in series with the main 5V input line. This allows you to either use a jumper to keep it "always on" (your Halloween plan) or connect the skull's built-in switch later.

Perfboard: Your BusBoard PR1590BB is a "dual-pad" or "PadBoard" style. This is perfect for creating strong, point-to-point soldered connections.

⚠️ Critical Issues & Final Questions
I have three final points to clarify. One is a major potential conflict that I've resolved, and two are warnings based on your decisions.

1. The GPIO 4 "Conflict" (Resolved) Your Hardware.md shows a major pin conflict that I need to point out:

Capacitive Sensor: Assigned to GPIO 4.

SD Card (SDMMC) Pin Map: Lists D1 = GPIO 4.

This looks like it would be a show-stopping failure. However, you are safe.

Your documentation also correctly notes that the firmware forces 1-bit SDMMC mode (SD_MMC.begin("/sdcard", true, ...)). In 1-bit mode, the SD card only uses CLK, CMD, D0, and D3. The D1 (GPIO 4) and D2 (GPIO 12) pins are not used by the SDMMC peripheral.

Therefore, using GPIO 4 for your sensor is 100% correct and conflict-free, but only because of that specific software choice. This is a subtle but critical detail, and I'm confirming your pinout is valid.

2. The Back-feed Diode (Your Decision) You've decided to omit the back-feed protection diode mentioned in your docs, relying instead on a "data-only" USB cable for programming.

This will work, but it carries risk. If you or anyone else ever forgets and plugs a normal data+power USB cable into the WROVER while the main 5V power is on, you will be connecting your computer's 5V USB port directly to your 5V power brick. This can (and often does) fry the USB port on your computer.

Final Check: Are you 100% sure you want to skip this $0.10 Schottky diode (like a 1N5822 minimum, or SR560 for ≥5 A) that would make this impossible to screw up? I can easily add it to the build plan.

3. 4-Foot Printer Cable Run A 4-foot run for the printer's UART (Serial) connection is very long for a standard signal.

At 9600 baud, it will probably work, but it is highly susceptible to electrical noise (especially from the servo), which could cause garbled text or missed commands.

Recommendation: Instead of flat Dupont-style wires, I strongly recommend using a shielded cable (connecting the shield to ground at the perfboard end only) or, at a minimum, a twisted pair from an old Ethernet cable (e.g., twist the TX wire with a GND wire, and the RX wire with another GND wire). This will make the connection significantly more reliable.

Once you confirm the diode decision (skip it or add it) and acknowledge the printer cable warning, I am ready to generate the full, step-by-step soldering guide.

Would you like me to proceed with the assembly instructions (and should I include the protection diode)?
