copperdogma/death-fortune-teller/docs/construction/skeleton.md

# Skeleton

"Home Accents Holiday 5 ft LED ULTRA Pose-N-Stay Skeleton"

Bought from Home Depot: https://www.homedepot.ca/product/home-accents-holiday-5-ft-led-ultra-pose-n-stay-skeleton/1001906564

This one's great because it already has 3 LEDs (2x eyes, 1x mouth), 3xAA battery pack, and a switch (I didn't use those two, but we could!).

Ideally I'd be able to buy JUST the head. The one I got was great but came with a whole skeleton. I don't want buy it and throw away the skeleton. Although we COULD find uses for the skeleton. And we could just retrofit Jeff/Anthony old head to a skeleton body to use a a prop/in the car/for something simple. Or just disassemble the skeleton and use it as bones, or the ribcage as a xlyophone or something.

20251102: GPT5 Deep Research on sourcing more skulls: https://chatgpt.com/c/69078c79-d454-832b-a2c7-d0cb80457f1a
- Not bad! https://www.amazon.com/Seasons-Skull-Skeleton-Halloween-Decoration/dp/B0F3CHC787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,8%20inches%20UPC%20192149606806
- Already animated with jaw motion: https://www.amazon.com/Crazy-Bonez-Animated-Skull-Light/dp/B094RKR718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
- MOVING eyes but looks bad: https://www.amazon.com/JOYIN-Halloween-Centerpiece-Decoration-Decorations/dp/B097YZR7Q7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
-
