copperdogma/death-fortune-teller/docs/hardware/58mm Embedded Thermal Receipt Printer Mini Printing Module Low Noise with RS232_TTL Serial Port Support ESC_POS Commands 5-9V - AliExpress 7/Printer character code and settings receipt that came with printer.jpg

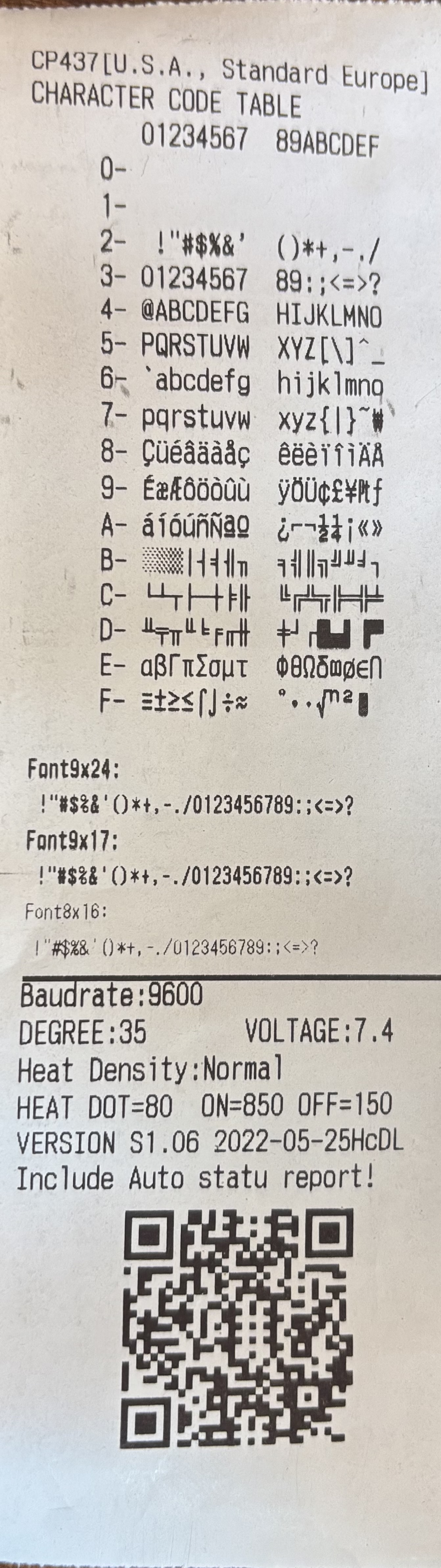
docs/hardware/58mm Embedded Thermal Receipt Printer Mini Printing Module Low Noise with RS232_TTL Serial Port Support ESC_POS Commands 5-9V - AliExpress 7/Printer character code and settings receipt 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
