copperdogma/death-fortune-teller/firmware/main/death_audio_reference.h

// Read-only diagnostic reference: initialized.wav file offset28672,4096 bytes.
#pragma once
#include <cstdint>
namespace skull::startup {
inline constexpr uint32_t reference_offset = 28672;
inline constexpr uint8_t reference_window[] = {
    0xb4,0x00,0xb8,0x00,0xb8,0x00,0xb6,0x00,0xb6,0x00,0xac,0x00,0xac,0x00,0xa8,0x00,0xa8,0x00,0xa7,0x00,0xa7,0x00,0xab,0x00,0xab,0x00,0xb8,0x00,0xb8,0x00,0xbd,0x00,
    0xbd,0x00,0xb7,0x00,0xb7,0x00,0xac,0x00,0xac,0x00,0x8f,0x00,0x8f,0x00,0x7d,0x00,0x7d,0x00,0x83,0x00,0x83,0x00,0x74,0x00,0x74,0x00,0x64,0x00,0x64,0x00,0x70,0x00,
    0x70,0x00,0x70,0x00,0x70,0x00,0x63,0x00,0x63,0x00,0x65,0x00,0x65,0x00,0x62,0x00,0x62,0x00,0x53,0x00,0x53,0x00,0x49,0x00,0x49,0x00,0x48,0x00,0x48,0x00,0x41,0x00,
    0x41,0x00,0x36,0x00,0x36,0x00,0x3a,0x00,0x3a,0x00,0x2e,0x00,0x2e,0x00,0x01,0x00,0x01,0x00,0xfd,0xff,0xfd,0xff,0x17,0x00,0x17,0x00,0x13,0x00,0x13,0x00,0x1d,0x00,
    0x1d,0x00,0x31,0x00,0x31,0x00,0x17,0x00,0x17,0x00,0xff,0xff,0xff,0xff,0xfc,0xff,0xfc,0xff,0xf0,0xff,0xf0,0xff,0x02,0x00,0x02,0x00,0x1d,0x00,0x1d,0x00,0x0c,0x00,
    0x0c,0x00,0x00,0x00,0x00,0x00,0x07,0x00,0x07,0x00,0xf4,0xff,0xf4,0xff,0xe2,0xff,0xe2,0xff,0xe6,0xff,0xe6,0xff,0xe7,0xff,0xe7,0xff,0xe6,0xff,0xe6,0xff,0xe9,0xff,
    0xe9,0xff,0xe6,0xff,0xe6,0xff,0xe8,0xff,0xe8,0xff,0xe8,0xff,0xe8,0xff,0xd8,0xff,0xd8,0xff,0xd0,0xff,0xd0,0xff,0xd7,0xff,0xd7,0xff,0xcb,0xff,0xcb,0xff,0xbd,0xff,
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
0xe78cdb72u,
0x290bfe4bu,
0x4a6f69afu,
0xa6a856dcu,
0x36e876deu,
0x56a5c246u,
0x8fe30f82u,
0x8b41767au,
0x7b26d625u,
0x7edcc86fu,
0x35bd5428u,
0x77aafe65u,
0x0c3fe540u,
0xc04903bdu,
0xbc8d8008u,
0xfc6d65e5u,
0x92e9e420u,
0x4cf74c64u,
0x735b75aau,
0x34fdb8eeu,
0xdba27370u,
0xea3530a4u,
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
};
}
