copperdogma/death-fortune-teller/src/fortune_generator.cpp

#include "fortune_generator.h"
#include "infra/filesystem.h"
#include "infra/random_source.h"
#include <ArduinoJson.h>
#include <cstdarg>
#include <cstdio>
#ifndef UNIT_TEST
#include "infra/sd_mmc_filesystem.h"
#include "infra/arduino_random_source.h"
#include "logging_manager.h"
#include "SD_MMC.h"
#endif
#include "infra/log_sink.h"

static constexpr const char* TAG = "FortuneGenerator";

FortuneGenerator::FortuneGenerator()
    : loaded(false),
      m_fileSystem(nullptr),
      m_randomSource(nullptr),
      m_logSink(nullptr) {
}

void FortuneGenerator::setFileSystem(infra::IFileSystem *fileSystem) {
    m_fileSystem = fileSystem;
}

void FortuneGenerator::setRandomSource(infra::IRandomSource *randomSource) {
    m_randomSource = randomSource;
}

void FortuneGenerator::setLogSink(infra::ILogSink *sink) {
    m_logSink = sink;
    infra::setLogSink(sink);
}

bool FortuneGenerator::loadFortunes(const String& filePath) {
    infra::IFileSystem *fs = resolveFileSystem();
    resolveLogSink();
    if (!fs) {
        log(infra::LogLevel::Error, "No filesystem available for fortune loading");
        return false;
    }

    auto file = fs->open(filePath.c_str(), FILE_READ);
    if (!file) {
        log(infra::LogLevel::Error, "Failed to open fortune file: %s", filePath.c_str());
        return false;
    }

    String jsonString = file->readString();
    file->close();
    
#if defined(__GNUC__)
#pragma GCC diagnostic push
#pragma GCC diagnostic ignored "-Wdeprecated-declarations"
#endif
    DynamicJsonDocument doc(2048);
#if defined(__GNUC__)
#pragma GCC diagnostic pop
#endif
    DeserializationError error = deserializeJson(doc, jsonString.c_str());

    if (error) {
        log(infra::LogLevel::Error, "Failed to parse fortune JSON: %s", error.c_str());
        return false;
    }

    // Parse version
    if (!doc["version"].is<int>()) {
        log(infra::LogLevel::Error, "Fortune file missing version");
        return false;
    }

    // Parse templates
    if (!doc["templates"].is<JsonArray>()) {
        log(infra::LogLevel::Error, "Fortune file missing or invalid templates");
        return false;
    }
    parseTemplates(doc["templates"]);

    // Parse wordlists
    if (!doc["wordlists"].is<JsonObject>()) {
        log(infra::LogLevel::Error, "Fortune file missing or invalid wordlists");
        return false;
    }
    parseWordlists(doc["wordlists"]);
    
    // Validate all templates
    for (const auto& template_obj : templates) {
        if (!validateTemplate(template_obj)) {
            log(infra::LogLevel::Error, "Invalid template: %s", template_obj.template_text.c_str());
            return false;
        }
    }

    loaded = true;
    log(infra::LogLevel::Info, "Loaded %u fortune templates", static_cast<unsigned>(templates.size()));
    return true;
}

String FortuneGenerator::generateFortune() {
    resolveLogSink();
    if (!loaded || templates.empty()) {
        log(infra::LogLevel::Warn, "generateFortune called before templates loaded");
        return "The spirits are silent...";
    }

    infra::IRandomSource *randomSource = resolveRandomSource();
    if (!randomSource) {
        log(infra::LogLevel::Error, "Random source unavailable; returning fallback fortune");
        return "The spirits are silent...";
    }

    // Select random template
    int templateIndex = randomSource->nextInt(0, static_cast<int>(templates.size()));
    const FortuneTemplate &fortuneTemplate = templates[templateIndex];

    if (fortuneTemplate.tokens.empty()) {
        log(infra::LogLevel::Warn, "Template has no tokens; returning literal text");
        return fortuneTemplate.template_text;
    }

    std::map<String, String> replacements;
    for (const auto &token : fortuneTemplate.tokens) {
        String replacement = getRandomWord(token);
        replacements[token] = replacement;
    }

    return replaceTokens(fortuneTemplate, replacements);
}

bool FortuneGenerator::isLoaded() {
    return loaded;
}

String FortuneGenerator::replaceTokens(const FortuneTemplate& fortuneTemplate, const std::map<String, String>& replacements) {
    String result;
    const String &templateText = fortuneTemplate.template_text;

    int length = templateText.length();
    int index = 0;
    while (index < length) {
        int tokenStart = templateText.indexOf("{{", index);
        if (tokenStart == -1) {
            result += templateText.substring(index);
            break;
        }

        result += templateText.substring(index, tokenStart);
        int tokenEnd = templateText.indexOf("}}", tokenStart + 2);
        if (tokenEnd == -1) {
            log(infra::LogLevel::Warn, "Unterminated token in template: %s", templateText.c_str());
            result += templateText.substring(tokenStart);
            break;
        }

        String token = templateText.substring(tokenStart + 2, tokenEnd);
        token.trim();
        auto it = replacements.find(token);
        if (it != replacements.end()) {
            result += it->second;
        } else {
            log(infra::LogLevel::Warn, "Missing replacement for token '%s'; leaving placeholder", token.c_str());
            result += "{{" + token + "}}";
        }
        index = tokenEnd + 2;
    }

    return result;
}

String FortuneGenerator::getRandomWord(const String& category) {
    resolveLogSink();
    if (wordlists.find(category) != wordlists.end() && !wordlists[category].empty()) {
        infra::IRandomSource *randomSource = resolveRandomSource();
        if (!randomSource) {
            log(infra::LogLevel::Error, "Random source unavailable when fetching token '%s'", category.c_str());
            return wordlists[category].front();
        }
        int index = randomSource->nextInt(0, static_cast<int>(wordlists[category].size()));
        return wordlists[category][index];
    }
    log(infra::LogLevel::Warn, "Wordlist missing or empty for token '%s'", category.c_str());
    return "mystery"; // Fallback word
}

bool FortuneGenerator::validateTemplate(const FortuneTemplate& fortuneTemplate) {
    if (fortuneTemplate.tokens.empty()) {
        log(infra::LogLevel::Warn, "Template has no tokens: %s", fortuneTemplate.template_text.c_str());
    }

    for (const auto &token : fortuneTemplate.tokens) {
        if (wordlists.find(token) == wordlists.end() || wordlists[token].empty()) {
            log(infra::LogLevel::Warn, "Token '%s' has no wordlist or empty wordlist", token.c_str());
            return false;
        }
    }
    
    return true;
}
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
