copperdogma/death-fortune-teller/(commit log)

2025-10-22 Initial PlatformIO port with working A2DP audio
    [config_primary.txt, config_secondary.txt]
2025-10-22 Refine Bluetooth reconnect flow and stabilize init queue
    [bluetooth_controller.cpp, bluetooth_controller.h, main.cpp]
2025-10-22 Wire jaw animator back into audio pipeline for sync test
2025-10-23 Add OTA tooling, docs, and logging updates
    [config.txt, fortune_ota.csv]
2025-10-23 Document OTA bring-up and log story tracker
    [fortune_ota.csv]
2025-10-23 Add Cursor slash commands and improve development workflow
    - Created 5 custom slash commands for ESP32 development workflow
    - Added check-in-diff, advice-for-past-self, fix-difficult-issue, you-pick, validate
    - Updated .gitignore to track .cursor/ folder for team collaboration
    - Reorganized documentation structure (moved stories to docs/)
    - Enhanced CHANGELOG.md with detailed change tracking
2025-10-24 Add comprehensive hardware documentation and proof-of-concept modules
    - Created docs/hardware.md with complete BOM and pin assignments
    - Added three proof-of-concept modules for Matter communication, finger detection, and thermal printing
    - Identified 5 critical pin conflicts requiring resolution before hardware assembly
    - Documented full ESP32-WROVER and ESP32-C3 SuperMini pinouts
    - Included hardware specifications, wiring layout, and troubleshooting guidance
    - Updated CHANGELOG.md with detailed hardware integration work
    [partitions.csv]
2025-10-25 Fix OTA system and add comprehensive debugging tools
    - Fixed OTA service 'No response from ESP' errors through proper firmware initialization
    - Optimized partition layout by removing unnecessary SPIFFS partition
    - Added auto-discovery OTA system for handling dynamic IP addresses
    - Enhanced telnet authentication with password support
    - Added comprehensive debugging tools and documentation
    - Improved OTA partition sizes and error handling
    [fortune_ota.csv]
2025-10-25 Complete Story 002: SD Audio Playback & Jaw Synchronization
    - Implement SkitSelector class with weighted selection algorithm
    - Add repeat prevention logic to avoid immediate skit repeats
    - Integrate skit selection with audio playback system
    - Add test function to validate skit selection functionality
    - Update story status to Complete in stories.md
    - All acceptance criteria met: SD card playback, jaw sync, repeat prevention
    [main.cpp, skit_selector.cpp, skit_selector.h]
2025-10-25 Add SD card config file for OTA system
    - Added sd-card-files/config.txt with proper WiFi and OTA credentials
    - Moved from root config.txt to organized sd-card-files/ directory
    - Includes working WiFi credentials and OTA password configuration
    [config.txt]
2025-10-25 Remove old config.txt as part of OTA reorganization
    - Deleted root config.txt file (moved to sd-card-files/config.txt)
    - Part of OTA system reorganization for better file structure
    - Config file now properly organized in sd-card-files/ directory
    [config.txt]
2025-10-25 Security: Remove hardcoded password from version control
    - Replace 'Death9!!!' with '***REDACTED***' in documentation and scripts
    - Preserve functionality while removing sensitive credentials
    - Files affected: ota-issues.md, telnet_command.py, ota-logging.md
    [telnet_command.py]
2025-10-25 Stabilize OTA with Bluetooth and document workflow
    [bluetooth_controller.cpp, bluetooth_controller.h, config_manager.cpp, config_manager.h, flash_and_monitor.py, main.cpp, ota_manager.cpp, ota_manager.h]
2025-10-25 Improve telnet stability and document OTA workflow
    [discover_esp32.py, remote_debug_manager.cpp, telnet_command.py]
2025-10-26 Add audio conversion system for ESP32 deployment
    - Added complete audio conversion pipeline for M4A to WAV conversion
    - Implemented intelligent silence trimming with natural audio buffer preservation
    - Added EBU R128 loudness normalization for consistent audio levels
    - Created automated batch processing with proper naming conventions
    - Added comprehensive documentation and specifications for ESP32 audio format
2025-10-26 Add converted audio files for ESP32 deployment
    - Added original M4A source files in audio-raw/placeholder/
    - Added converted WAV files with optimized silence trimming and normalization
    - All audio files ready for ESP32 SD card deployment
    - Files include: welcome, finger_prompt, fortune, goodbye, got_finger, no_finger
2025-10-26 Implement breathing cycle idle animation (Story 001b)
    - Added breathing function with 7-second interval jaw movement
    - Enhanced servo PWM resolution to 20-bit for smoother control
    - Integrated breathing cycle into main loop with audio-aware activation
    - Created issues tracking document for servo smoothness limitation
    - Updated story documentation and changelog
    This implements the breathing cycle feature from TwoSkulls where
    the jaw opens and closes every 7 seconds when idle. The implementation
    follows the same logic as the reference but uses ESP32Servo library
    which has known smoothness limitations documented in issues.md
    [main.cpp, servo_controller.cpp]
2025-10-26 Story 001a: Complete Configuration Management System implementation
    - Implemented all 15 configuration keys from spec.md §8
    - Added type-safe getter methods for all configuration values
    - Implemented two-layer validation (warnings + runtime enforcement)
    - All getters return safe defaults when values are invalid
    - Updated SD_CARD_SETUP.md with complete configuration documentation
    - Updated config.txt template with all configuration keys
    - Removed unused remote debug configuration keys
    - Tested on hardware with valid, invalid, and missing configurations
    - Story 001a marked as Done
    [config.txt]
2025-10-26 Update LED system to use pink LEDs with recalculated resistor values
    - Updated all documentation to specify pink LEDs from BOJACK kit
    - Added comprehensive resistor calculation section
    - Recalculated resistor value for pink LED forward voltage (3.0-3.2V)
    - Confirmed 100Ω resistor is correct for safety margin and voltage tolerance
    - Updated hardware.md, hardware-led_cluster_wiring_diagram.md, and CHANGELOG.md
2025-10-26 Added LED hardware reference
2025-10-26 Updated SD card specs: needs 5v and has max 200mA draw
2025-10-26 Documentation: Align with Matter controller canonical command codes
    - Updated spec.md to focus on requirements, removed UART implementation details
    - Added complete Matter controller state mapping (12 command codes 0x01-0x0C)
    - Updated stories with canonical command codes and existing code references
    - Documented state forcing behavior requirements
    - Updated UART command names to match Matter controller
    - Updated LED pin configuration documentation
    - Added Matter controller repository link to README
2025-10-27 Hardware milestone: ESP32-WROVER fully operational with SD card, LEDs, Bluetooth, and audio playback
    - Fixed SkitSelector crash when initialized with empty skit list
    - Removed jaw sync test override code
    - Simplified initialization audio path handling
    - Verified complete hardware bootstrap: SD card, LEDs, Bluetooth A2DP, audio playback
    [main.cpp, skit_selector.cpp]
2025-10-27 Refine servo initialization and LED system
    - Eliminate double servo initialization by loading SD card/config first
    - Add servo_init serial command for manual initialization sweep
    - Improve servo sweep timing using smoothMove() with 1.5s per direction
    - Refactor LED system from dual-eye to eye+mouth configuration
    - Add sequential LED blinking (blinkLights) and mouth-specific blinking
    - Update config manager defaults to safer 1400-1600µs servo limits
    - Improve error handling with configurable retry limits
    All changes tested on hardware and verified working.
    [config.txt]
2025-10-27 Add ServoTester utility for servo limit calibration
    - Add ServoTester class for finding servo safe limits with microsecond precision
    - Provides serial commands to test servo ranges: 'servo <offset>' or 'servo'
    - Includes comprehensive documentation in header for integration and usage
    - Useful for calibrating servo min/max values before production configuration
2025-10-27 Fix: Add missing update() calls to main loop for audio playback
    - Added audioPlayer->update() to fill audio buffer from SD card
    - Added bluetoothController->update() to process media start requests
    - Fixes issue where queued audio files weren't playing after Bluetooth connection
    - Audio buffer now fills and A2DP media start properly triggered
    Resolves audio playback issue documented in ai-work/issues/a2dp-issues.md
    [main.cpp]
2025-10-27 Fix: Restore breathing animation idle cycle
    Breathing animation code existed but wasn't being called in loop().
    Added breathing timing check back to main loop that triggers every
    7 seconds when idle and no audio is playing. Jaw now properly animates
    with breathing cycle that was missing since loop refactoring.
    [main.cpp]
2025-10-27 Refactor: Remove config-based primary/secondary role, hard-code as primary coordinator
    - Removed role=primary from config.txt
    - Hard-coded skull as primary/coordinator animatronic in main.cpp
    - Removed unused primary/secondary SD card fields and MAC address methods
    - Kept SkullAudioAnimator extensible for future secondary animatronics
    - Simplified initialization audio path logic
    - Cleaned up debug output
    - Net: -61 lines, improved maintainability
    [config.txt]
2025-10-27 Add Matter UART diagnostics and adjust hardware wiring
2025-10-27 Implement Matter state machine and finalize UART handling
2025-10-28 Polish fortune flow and mark story 003a complete
2025-10-28 Migrate to SD_MMC slot and update servo/docs
2025-10-28 LED code tweak
2025-10-29 Implement capacitive sensor tuning and LED flow
    [config.txt]
2025-10-29 Enhance LED calibration cues and fault logging
2025-10-29 UART protocol story + implementation: raw RX logging, text NEAR/FAR/[STATE], binary handshakes (BOOT_HELLO/FABRIC_HELLO) with ACKs; main status reporting; docs updated
2025-10-29 Document printer power fix and revert fortune formatting
2025-10-29 docs(stories): add Story 009 — Access WROVER SD Card from USB-C; research feasibility, options, and plan
2025-10-29 docs(hardware): sync pins with firmware: UART1 Matter (TX=21,RX=22), UART2 printer (TX=18,RX=19); confirm no GPIO conflicts; update wiring overview
2025-10-29 Adaptive finger sensor settling and calibration hold
    [config.txt]
2025-10-31 Keep jaw open during finger wait and coordinate fortune printing
2025-10-31 Cache printer logo and stream fortune print job
2025-10-31 Docs: Added perfboard-assembly.md instructions, cleaned up others
2025-10-31 Fixed issues with blocking the rest of the code when the printer was working
    [thermal_printer.cpp, thermal_printer.h]
2025-10-31 Add servo direction reversal and comprehensive tuning commands
    - Implemented servo direction reversal via software mapping (180-angle)
    - Added comprehensive CLI commands: smin, smax, sinit, scfg, smic, sdeg, srev
    - Added servo_reverse config parameter (default: false)
    - Fixed initialization sweep to use smoothMove() for proper timing
    - Added interactive tuning with overloads: smin <value>, smin +/-, etc.
    - Enhanced config display showing min/max µs and reversal state
    - Increased servo µs range from 2500 to 10000
    - Renamed servo_init to sinit for consistency
    - Comprehensive documentation in servo-issues.md (162 lines)
    [config.txt]
2025-10-31 Remove completed servo command test note
2025-10-31 docs: record servo quiet band findings
2025-10-31 refactor: replace smoothMove with instant positioning in servo init
    [servo_controller.cpp]
2025-11-02 Removed POC code
    [config_primary.txt, config_secondary.txt, partitions.csv]
2025-11-09 Refactored code
    - Replace the giant runtime blob with a lean AppController that wires modules through ModuleOptions and ModuleProviders, keeping Arduino setup/loop straightforward.
    - Restore the “keeper” CLI/content modules with host-friendly guards and stubs, so their native unit tests build and run again.
    - Add compile-time toggles plus README guidance for enabling/disabling CLI, printer, connectivity, etc., and inject Bluetooth into RemoteDebugManager instead of relying on globals.
    [Print.h, Servo.h, app_controller.cpp, app_controller.h, audio_directory_selector.cpp, audio_directory_selector.h, audio_player.cpp, audio_player.h]
2026-07-20 Document project context and 2026 button box plan
2026-10-26 Rebuild Death on one WROVER with Matter demo controls and paced printing
2026-10-27 Polish fortune printing with smaller centered logo and sentence spacing
