copperdogma/death-fortune-teller/docs/written-notes/death_madlib_2025.JPEG

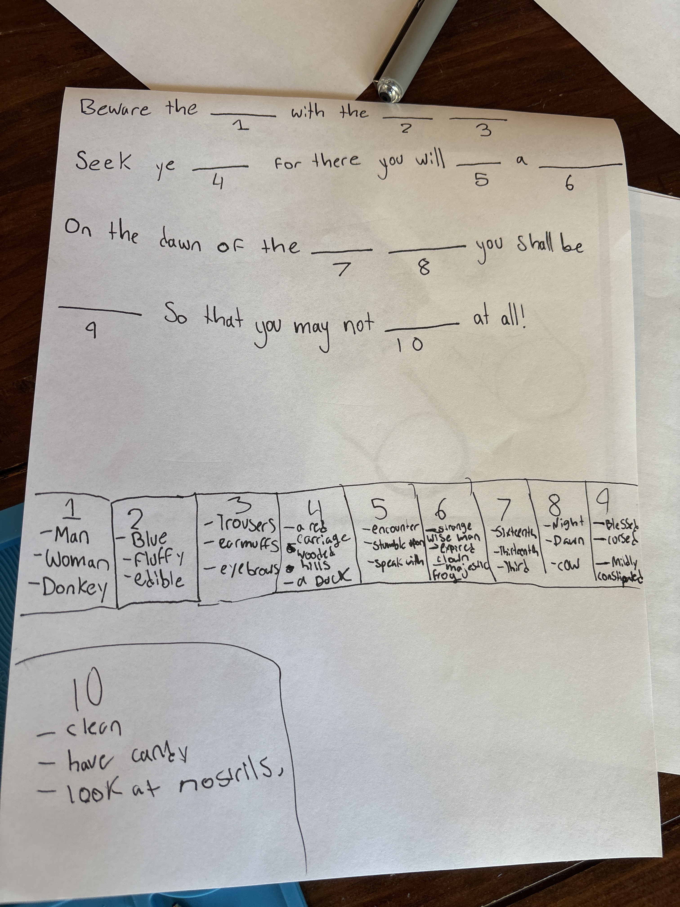
docs/written-notes/death_madlib_2025.JPEG
